joakimgk/trafikklys/img/DSC_0760.JPG

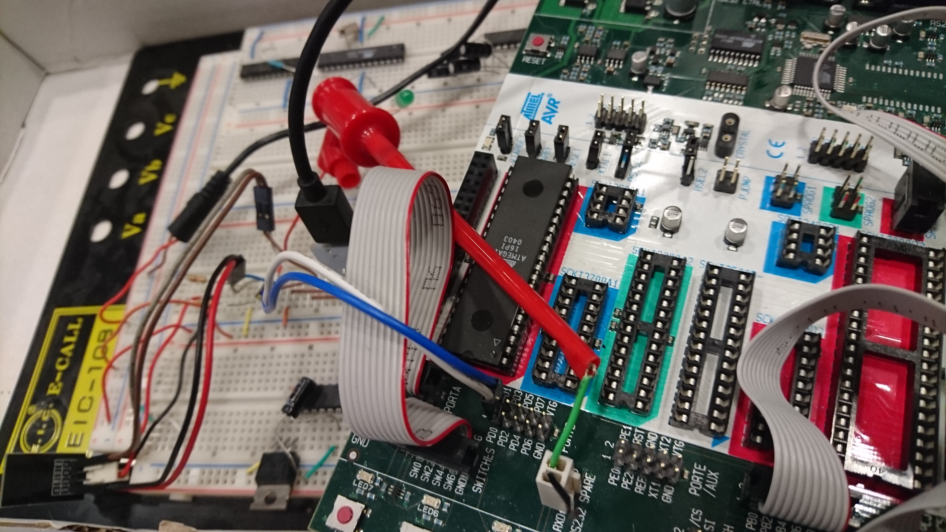
img/DSC_0760.JPG
