joakimgk/trafikklys/img/DSC_0761.JPG

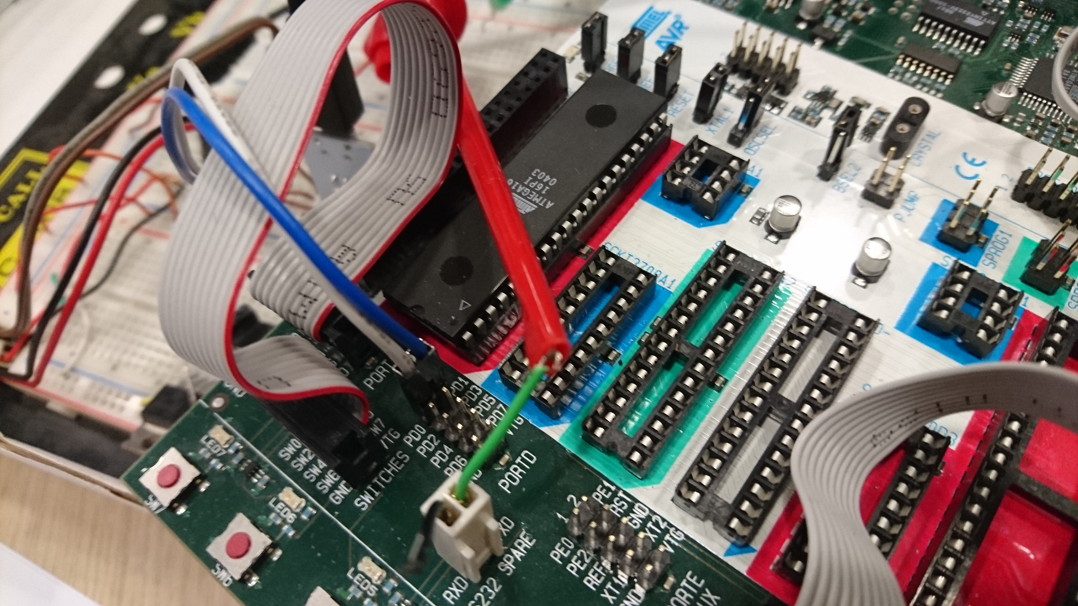
img/DSC_0761.JPG
