joakimgk/trafikklys/img/IMG_9375.jpg

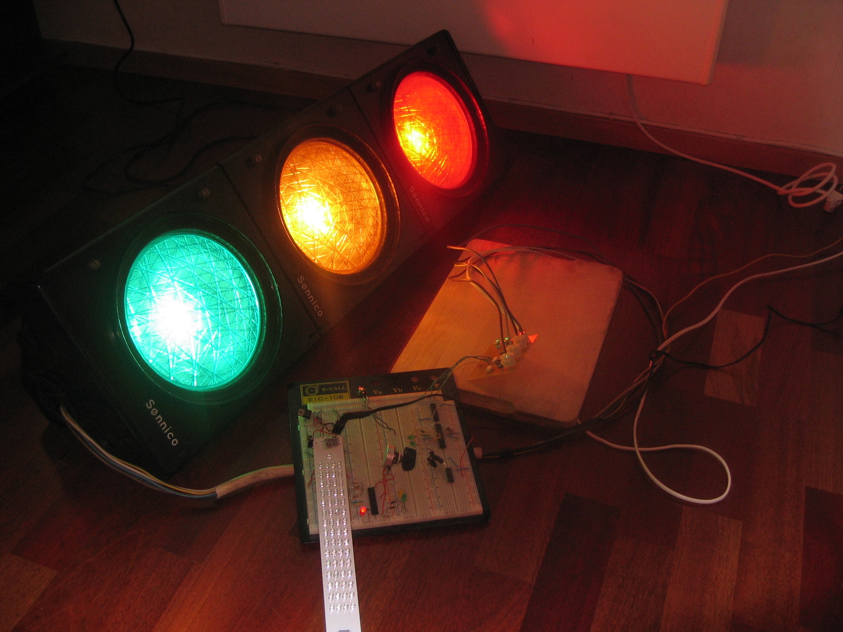
img/IMG_9375.jpg
