joakimgk/trafikklys/img/IMG_9376.jpg

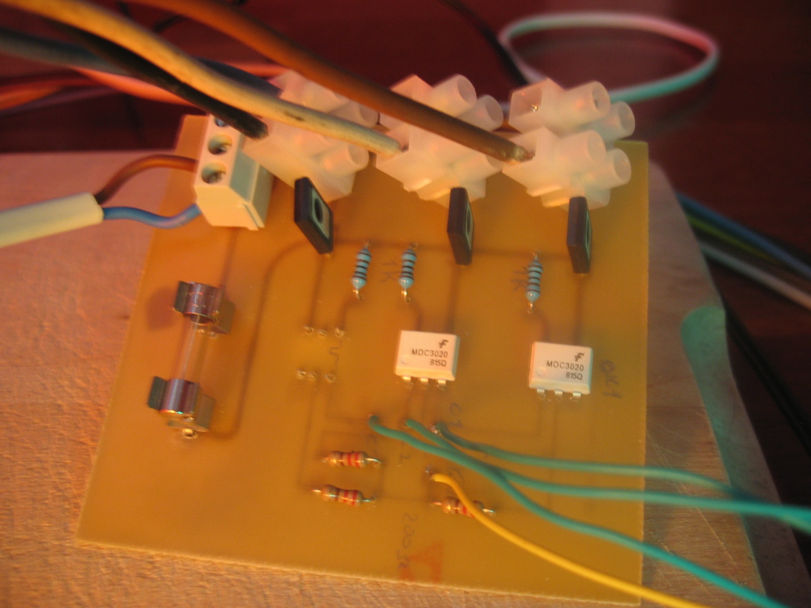
img/IMG_9376.jpg
