joakimgk/trafikklys/(commit log)

2018-11-13 Kommentarer fra Øyvind
    Funker fremdeles ikke HELT. Kommer forbi første steg i initialiseringen, hvor det blinker SLOW til man trykker SW0. Terminalen (se nedenfor) viser da "Tast ID, 1-16" og det starter å blinke RAPID, men den ser ikke ut til å respondere på inntastet char. Vanskelig å si (siden det er hardware, og hvordan skal man debugge) men kanskje jeg ikke kommer inn i interrupten i det hele tatt?
    Press SW0 to start initialization...Tast ID, 1-165
    5
    5
    5
    5
    5
    5
    5
2019-06-19 Utvidet med receive, og la tilbake parsing av kommandoer. Funker ikke, klarer tydeligvis ikke helt å motta data på en ryddig måte enda
2019-10-05 Update main.c
    Fikset oppsett Timer1 (CTC mode)
2019-10-12 Added driver schematic
2019-10-23 Ryddet i bruk av timer1
2021-08-29 Update old code
    Important changes to prevent crashing
    [main.c]
2021-09-05 Basic version of sync (jitter) protocol
    Also, randomised selection of master role. This also works if master node goes down.
    [main.c]
2021-09-12 Basic setup for status indicator LEDs
2021-09-26 Clean up to run without crash
    Comment out code (especially the new ESP8266_Send_UDP) which is not used yet. This code, just being there, seems to cause the program/chip to crash (reset) randomly
    [main.c]
2021-10-09 Update main.c
    sprintf in ESP8266_Send_UDP is still causing the AVR to crash/restart
    [main.c]
2021-10-10 Reduce memory usage
    This seems to resolve the runtime crashes
    [main.c]
2021-10-11 Sync message and master state
    Using PORTC as indicator LEDs
2021-10-13 Adjust sync timer
2021-11-17 Make Read_Data more robust
    Delays while reading chars, and waits until '\r\n' (with timeout)
    Will exit gracefully if buffer overflow (still null terminated) and set error flags (PC6, PC7)
    [main.c]
2023-08-21 Adjustments to jitter compensation
    [trafikklys.ino]
2023-11-20 Attempt at sending, through AsyncTCP lib
    Fails, as `canSend` = false (because `space()` returns 0, for some reason)
    As per example: https://github.com/me-no-dev/ESPAsyncTCP/blob/master/examples/ClientServer/Client/Client.ino
    and
    https://github.com/me-no-dev/ESPAsyncTCP/blob/15476867dcbab906c0f1d47a7f63cdde223abeab/src/ESPAsyncTCP.cpp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
    [trafikklys.ino]
2025-02-06 Fixed glitchy performance
    Don't blink() inside ISR (just set flag)
    Avoid serial.write
    Reduce delay in loop
    [trafikklys.ino]
